rettigs/rob421-applied-robotics/pictures/vision_test_2015-04-14.jpg

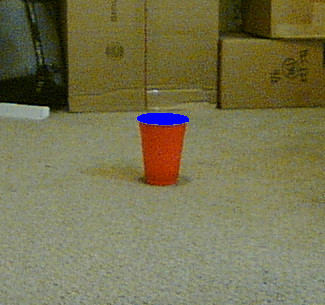
pictures/vision_test_2015-04-14.jpg
