rettigs/rob421-applied-robotics/pictures/accuracy_test_2015-04-21.jpg

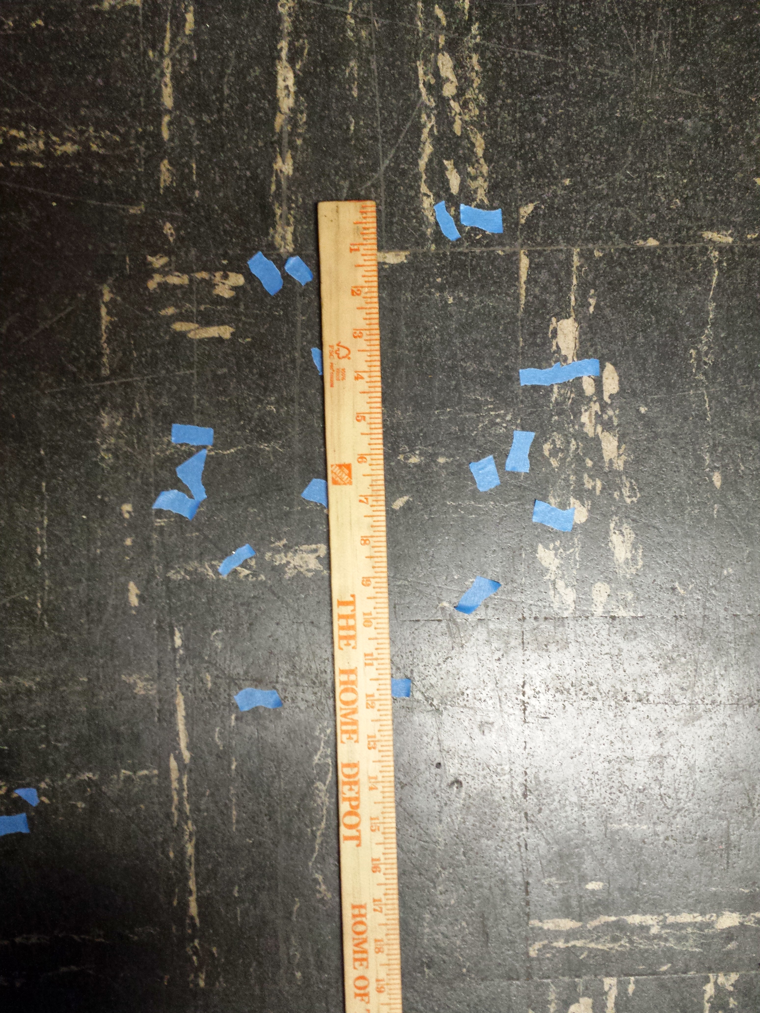
pictures/accuracy_test_2015-04-21.jpg
