rettigs/rob421-applied-robotics/documents/HW 2 Flowchart of Functions.odp

Start

Initialize

Wait for

turn info

Calculate

cup distance

Wait for

cup selection

Our

turn

Enemy

turn

Track

incoming ball

Did it bounce?

Yes

Spin up

launch motor

Error correction

No

Did it hit?

No

Move carriage

Track incoming ball

Release ball

Yes
