rettigs/rob421-applied-robotics/documents/HW 2 Flowchart of Functions.png

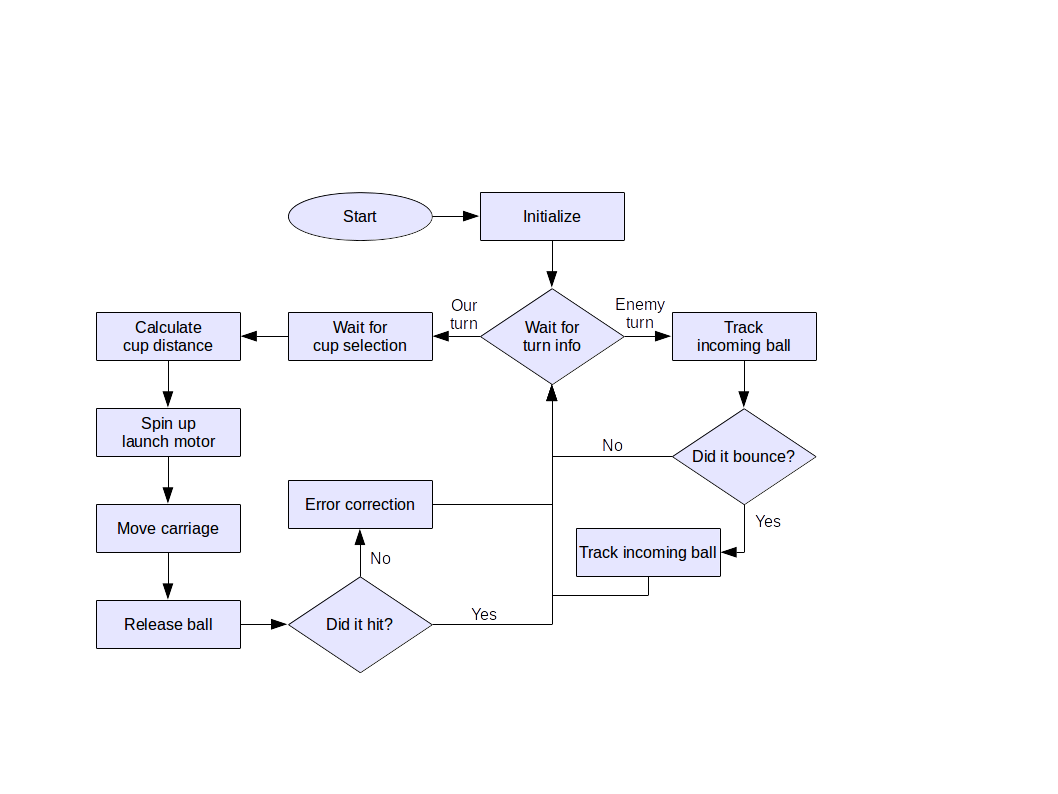
documents/HW 2 Flowchart of Functions.png
