rettigs/rob421-applied-robotics/pictures/IMG_20150418_081723.jpg

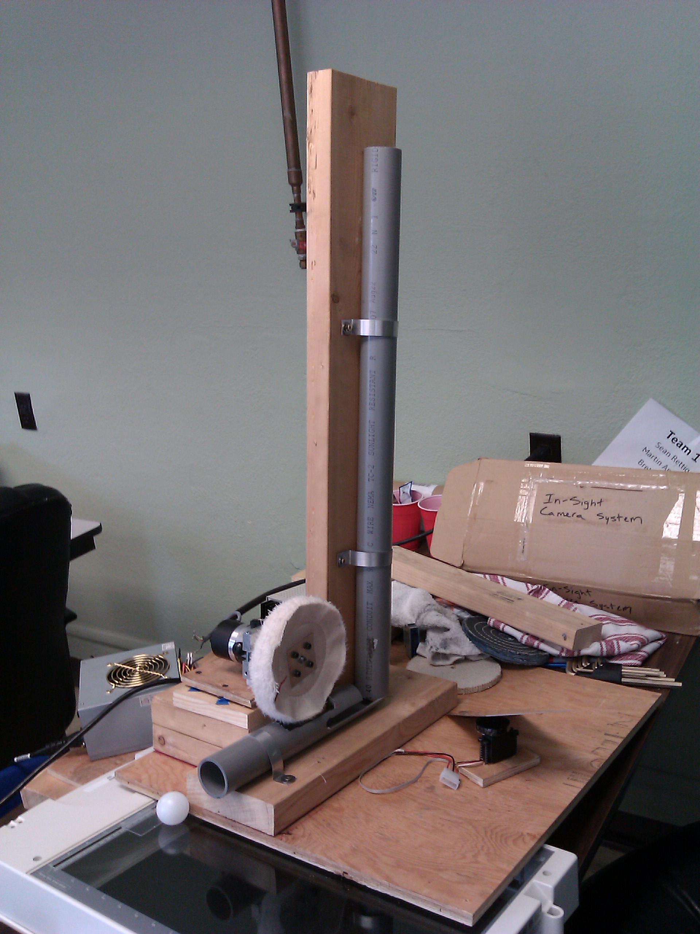
pictures/IMG_20150418_081723.jpg
