rettigs/rob421-applied-robotics/pictures/IMG_20150418_081751.jpg

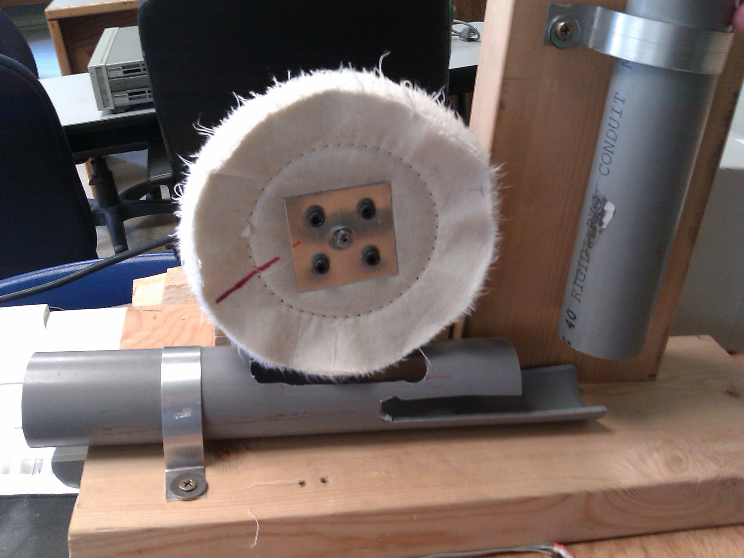
pictures/IMG_20150418_081751.jpg
