rettigs/rob421-applied-robotics/pictures/IMG_20150418_081830.jpg

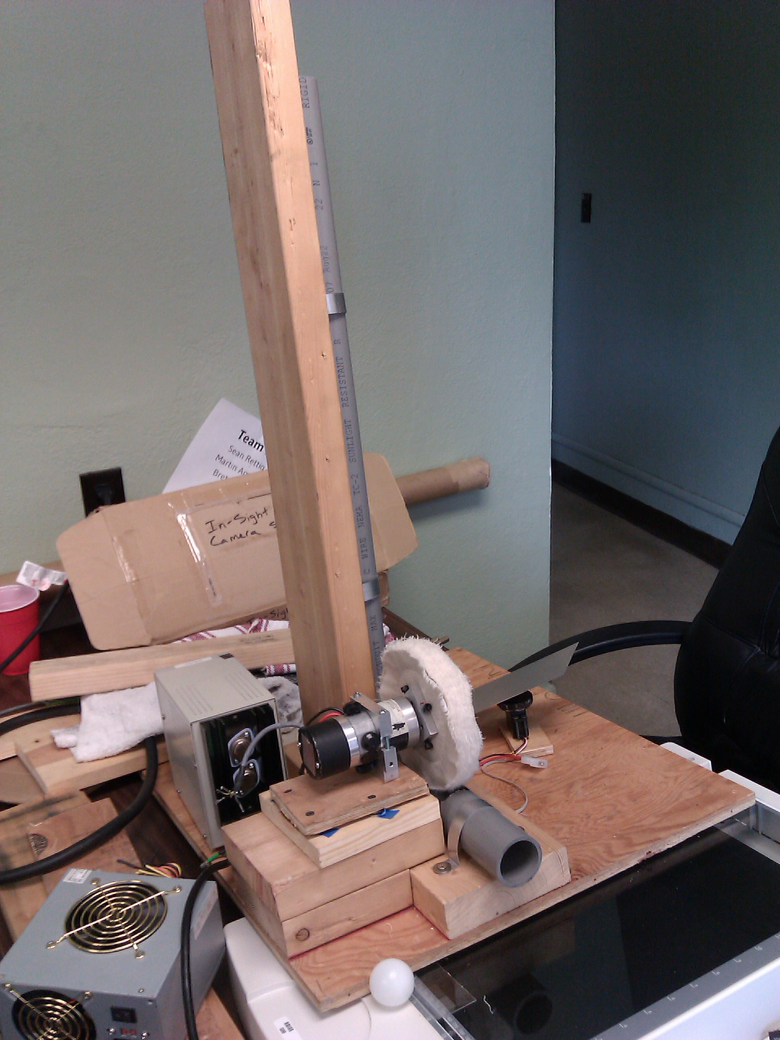
pictures/IMG_20150418_081830.jpg
