rettigs/rob421-applied-robotics/pictures/IMG_20150426_173550.jpg

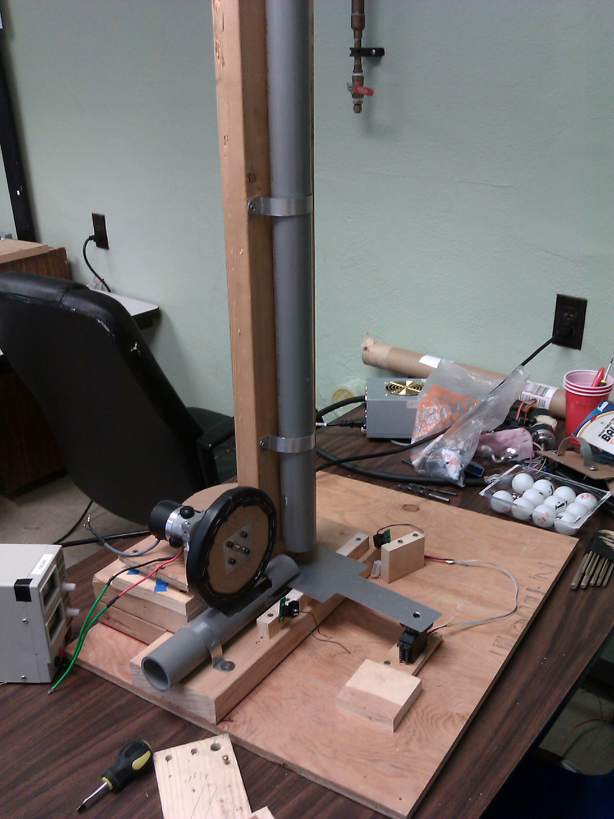
pictures/IMG_20150426_173550.jpg
