rettigs/rob421-applied-robotics/pictures/IMG_20150426_173609.jpg

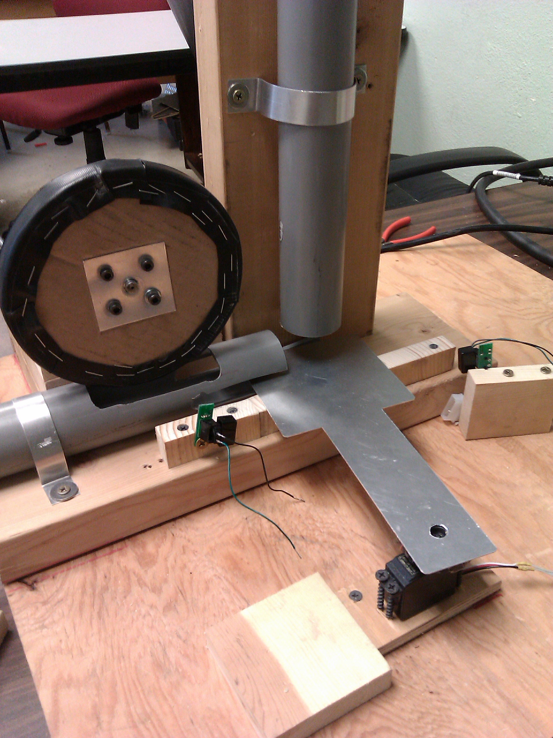
pictures/IMG_20150426_173609.jpg
