rettigs/rob421-applied-robotics/pictures/IMG_20150426_173624.jpg

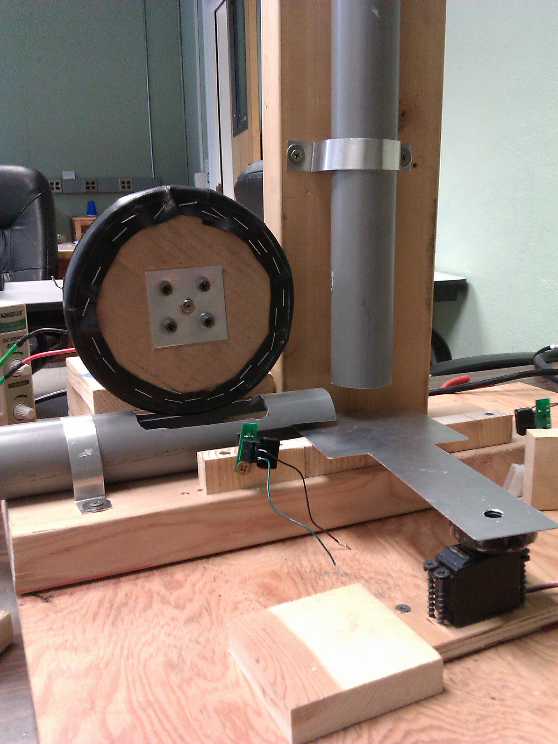
pictures/IMG_20150426_173624.jpg
