rettigs/rob421-applied-robotics/opt_flow.py

#!/usr/bin/env python

import math
import numpy as np
import cv2
import video
from common import draw_str

help_message = '''
USAGE: opt_flow.py [<video_source>]
'''

def draw_flow(img, flow, step=8):
    h, w = img.shape[:2]
    y, x = np.mgrid[step/2:h:step, step/2:w:step].reshape(2,-1)
    fx, fy = flow[y,x].T
    lines = np.vstack([x, y, x+fx, y+fy]).T.reshape(-1, 2, 2)
    lines = np.int32(lines + 0.5)
    vis = cv2.cvtColor(img, cv2.COLOR_GRAY2BGR)
    cv2.polylines(vis, lines, 0, (0, 255, 0))
    for (x1, y1), (x2, y2) in lines:
        cv2.circle(vis, (x1, y1), 1, (0, 255, 0), -1)
        mag = math.sqrt((x2-x1)**2 + (y2-y1)**2)
        draw_str(vis, (x1, y1), "{}".format(int(mag)))
    return vis

if __name__ == '__main__':
    import sys
    print help_message
    try: fn = sys.argv[1]
    except: fn = 0

    cam = video.create_capture(fn)
    ret, prev = cam.read()
    prevgray = cv2.cvtColor(prev, cv2.COLOR_BGR2GRAY)

    while True:
        ret, img = cam.read()
        #img = cv2.flip(img, -1)
        gray = cv2.cvtColor(img, cv2.COLOR_BGR2GRAY)
        flow = cv2.calcOpticalFlowFarneback(prevgray, gray, 0.5, 3, 15, 3, 5, 1.2, 0)
        prevgray = gray

        cv2.imshow('flow', draw_flow(gray, flow))

        ch = 0xFF & cv2.waitKey(5)
        if ch == 27:
            break
    cv2.destroyAllWindows()
