rettigs/rob421-applied-robotics/(commit log)

2015-04-07 add opencv samples to mess around with
2015-04-07 Added HSV Tracking File
    Basic tracking file with track bars to adjust HSV object detection.
2015-04-09 hw2: add block diagram and flowchart of functions
2015-04-09 hw2: fix flowchart of functions
2015-04-09 hw2: put updated flowchart of functions in hw2
2015-04-21 replace ellipse detection function with something not terrible
    [cupdetect.py, remote_video.py]
2015-04-21 don't crash if it detects a small ellipse
    [cupdetect.py]
2015-04-28 update gitignore, commit opencv samples to mess with
2015-04-28 fix rectselector, mosse program seems to track cups well
    [common.py]
2015-04-30 remove unused samples
2015-05-08 tweak automatic carriage moving
2015-05-20 tweak launch motor speeds and flip camera
    [app.py]
2015-05-26 unflip camera
2015-05-26 Revert "unflip camera"
    This reverts commit 7dbae08cbfabe6d2ccfad7019063f7c2edb56416.
    [app.py]
2015-05-29 tweak motor control numbers and controls
2015-05-29 Revert "Revert "unflip camera""
    This reverts commit 6a383182d761a9c966d0a3da408390fa3ec60989.
    [app.py]
2015-06-02 Revert "Revert "Revert "unflip camera"""
    This reverts commit dc2ca648d6677d8bb9cb574065da4b957138b197.
    [app.py]
2015-06-04 update launch motor speeds
2015-06-04 show actual motor speed in gui
2015-06-04 tweaks to motor values
2015-06-04 Revert "try to integrate bounce shot detection into combined robot"
    This reverts commit 7eafea116b425ac1f9305bc7cf2ae20e938e6325.
    [app.py, main.py]
2015-06-04 Revert "Revert "try to integrate bounce shot detection into combined robot""
    This reverts commit 0f5bed5f695981c497299d0544b9ffeb7abd47fc.
    [app.py, main.py]
2015-06-04 Revert "Revert "Revert "try to integrate bounce shot detection into combined robot"""
    This reverts commit d2bde21a123a3576d31dc3d0cd8083f03368bc55.
    Conflicts:
    combined_robot/app.py
    [app.py, main.py]
2015-06-09 adjust swatting arm position
